tscircuit/probe-stage01/versions/v1/site/downloads/README.txt

Microscope probe lift — build123d prototype 03

End mount for a Ø44 mm microscope cylinder, with a nominal 44.4 mm split-clamp bore and a 100 mm working distance to the specimen. The carriage moves 40 mm straight vertically; the externally held probe remains 60° above the plate. A custom necked metal probe has a 1 mm stem in the central field and a 6 mm shank in the external collet. Confirm the actual objective envelope and optical field.

Drive: module 1, 20° pressure angle, 20-tooth pinion engaging 60 internal teeth in a 180° slot of a virtual 120-tooth ring. Ratio 6:1. Wheel OD 136 mm; crank radius 25 mm; connecting rod 110 mm; wheel sweep approximately 106.26° for the 40 mm stroke.

Probe reference: custom 104 mm metal probe. The first 4 mm is pointed; the 1 mm stem continues to 60 mm from the tip; a taper spans 60–70 mm; the 6 mm shank spans 70–104 mm. Collet mid-plane is 90 mm from the tip, at world X=45 mm. This is an illustrative probe geometry, not a supplied or load-rated probe. Confirm suitability for your experiment.

Hardware: four 625ZZ bearings (5 × 16 × 5 mm). M5 structural and pivot fasteners; four M3 motor mounting screws. Modeled M5 heads are low profile, 8.5 mm diameter × 3.5 mm high. Use smooth precision 5 mm running sections through bearing races, with M5 threads outside the races. Standard 6 mm shoulder bolts do not fit. Verify actual screw lengths, head envelopes, motor mounting and shaft dimensions.

Nominal allowances: microscope bore +0.4 mm diameter; bearing seats +0.1 mm diameter; probe bore +0.35 mm diameter; M5 clearance holes 5.3 mm; dovetail lateral clearance 0.3 mm. Calibrate for your material and process. Do not clamp rotating bearing races with the surrounding printed shoulder.

All 48 exported components are valid single solids and passed STEP roundtrip checks. No intersections at 41 checked poses; Ø44 projected optical field clear of printed parts. Every component pair was checked at each pose (1128 pairs per pose), with no excluded parts or regions. A conservative full-length Ø6 mm probe envelope was also checked against every other component, replacing the necked probe reference. This is a geometry and motion prototype; stiffness, strength, backlash, fit tolerances and manufacturing need physical validation. These sampled checks do not prove clearance at every intermediate position. Separate conservative bounds keep every printed part outside the Ø44 projected barrel corridor throughout the prescribed vertical stroke, with the bounds checked against a 24 mm corridor radius. The projected footprint is not a measured lens field of view. The checked minimum gap between a full-length Ø6 mm probe envelope and the front clamp is 1.885 mm.

Audit threshold: positive-volume intersections greater than 1e-5 mm³ are reported. Tangent contact is allowed, including the lowered probe tip on the specimen. The Ø44 projected column is an optical clearance assumption from the barrel end to the specimen, not a measured microscope field. The slender metal probe intentionally enters that field; printed parts do not.

STEP is available for all 48 displayed components and the complete assembly. Genuine Parasolid x_t export is unavailable because no licensed writer is installed. Import STEP into a CAD tool with a Parasolid exporter to produce x_t. The complete bundle includes build123d source, requirements, all component STEP files, seven printable-part STLs, assembly STEP/GLB, viewer geometry, dimensions, manifests, checksums and verification reports. CAD downloads share the lowered contact-pose assembly placement; arrange STL orientations in your slicer.

Regenerate: install requirements.txt, then run python slider_crank_v3.py --out ./regenerated. Default assembly pose is lowered specimen contact at a 100 mm working distance. --angle selects a crank angle in degrees within ±53.130102354°. --working-distance changes the specimen offset and requires a new clearance audit. Viewer tessellation uses phi=0; the viewer applies rigid part transforms for animation.
