tscircuit/probe-stage01/validation/v4/v4-optical-40mm.png

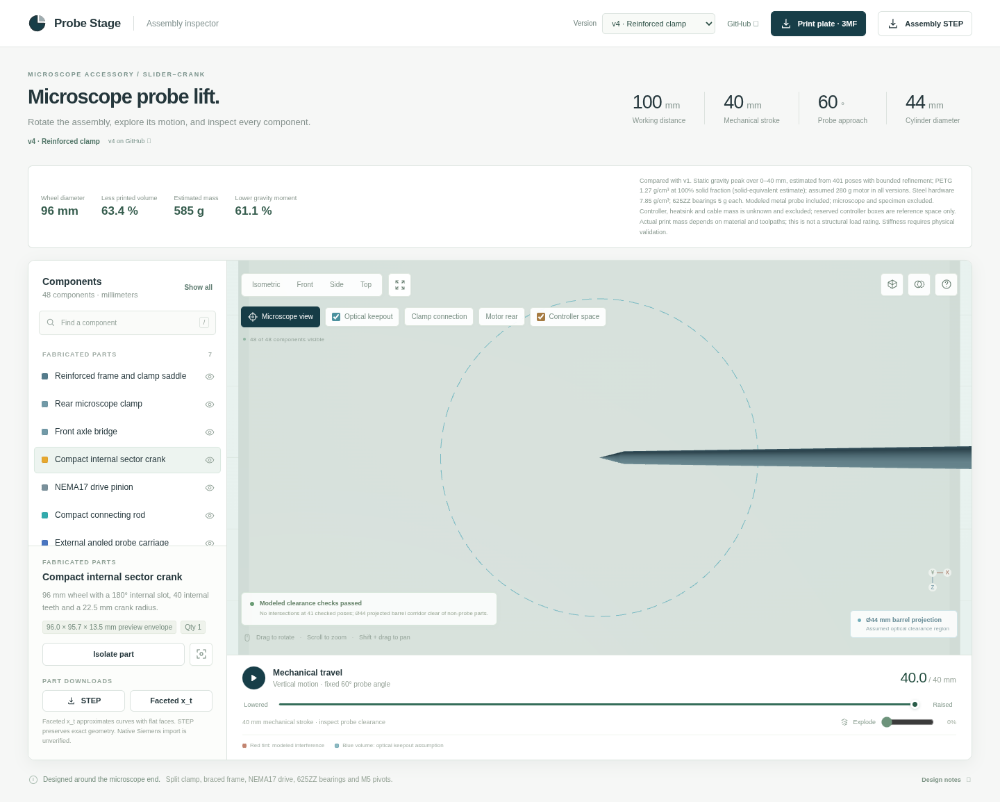
validation/v4/v4-optical-40mm.png
