tscircuit/probe-stage01/versions/v4/site/downloads/probe_stage_v4_assembly.step

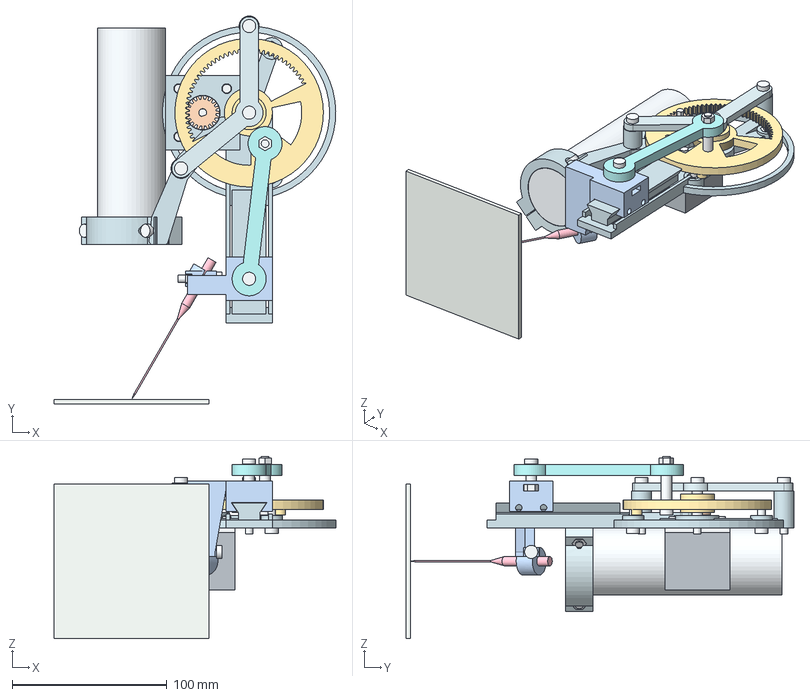
[picture p3: CAD file, 2026-10-10]
versions/v4/site/downloads/probe_stage_v4_assembly.step
182.0 x 250.8 x 117.7 mm
frame_front_clamp
rear_clamp
front_axle_bridge
sector_crank
motor_pinion
connecting_rod
probe_carriage
625ZZ_wheel_rear
625ZZ_wheel_front
625ZZ_crank
625ZZ_slider
wheel_inner_spacer
wheel_rear_spacer
wheel_front_spacer
crank_rear_spacer
crank_front_spacer
slider_rear_spacer
slider_front_spacer
M5_wheel_axle
M5_crank_bolt
M5_crank_nut
M5_slider_pivot_bolt
M5_slider_captive_nut
M5_axle_captive_nut
NEMA17_body
NEMA17_face
motor_shaft
M3_motor_-15.5_-15.5
M3_motor_-15.5_15.5
M3_motor_15.5_-15.5
M3_motor_15.5_15.5
M5_stop_-1
M5_stop_nut_-1
M5_stop_1
M5_stop_nut_1
M5_clamp_-28
M5_clamp_nut_-28
M5_clamp_28
M5_clamp_nut_28
M5_bridge_bolt_0
M5_bridge_nut_0
M5_bridge_bolt_1
M5_bridge_nut_1
M5_probe_clamp_bolt
M5_probe_clamp_nut
microscope_reference
probe_reference
specimen_plate_reference
