tscircuit/probe-stage01/print-plates/v4/probe-stage-v4-print-plate.3mf

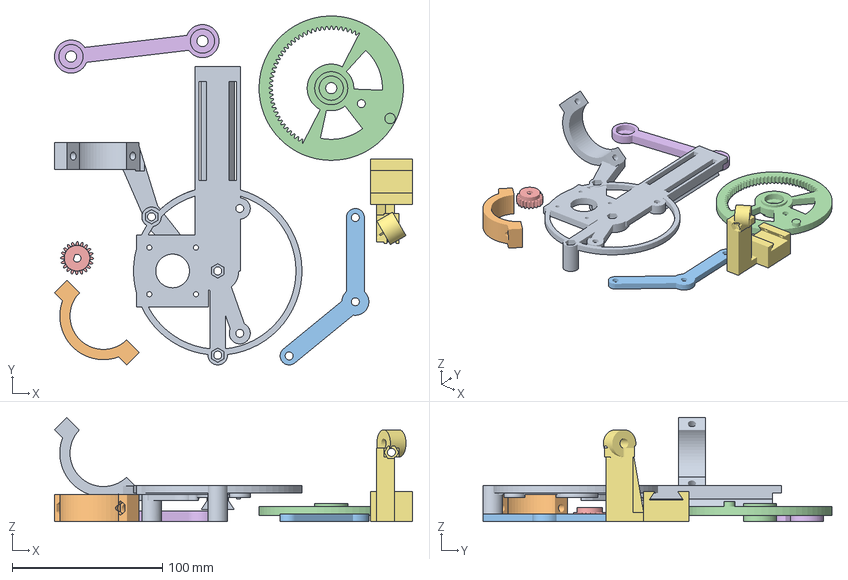
[picture p4: CAD file, 2026-10-10]
print-plates/v4/probe-stage-v4-print-plate.3mf
238.0 x 231.9 x 69.3 mm
frame_front_clamp
rear_clamp
front_axle_bridge
sector_crank
motor_pinion
connecting_rod
probe_carriage
