tscircuit/probe-stage01/versions/v4/site/downloads/parts/probe_reference.step

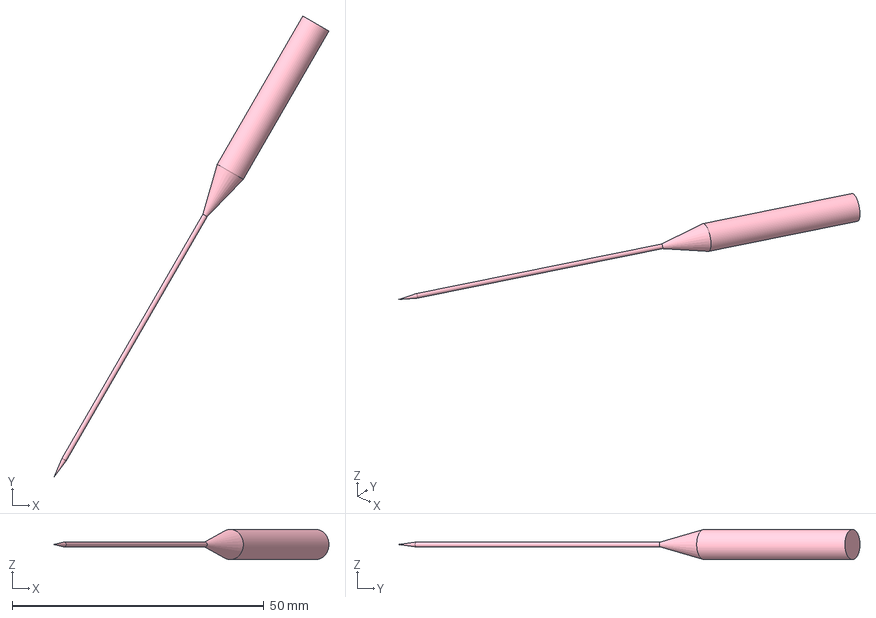
[picture p5: CAD file, 2026-10-10]
versions/v4/site/downloads/parts/probe_reference.step
54.6 x 91.6 x 6.00 mm
