tscircuit/probe-stage01/versions/v4/site/downloads/references/motor_controller_clearance_keepout.step

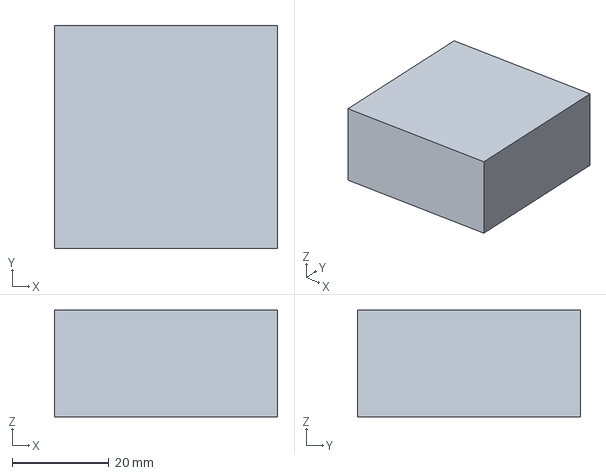
[picture p6: CAD file, 2026-10-10]
versions/v4/site/downloads/references/motor_controller_clearance_keepout.step
46.0 x 46.0 x 22.0 mm
