tscircuit/probe-stage01/versions/v4/site/downloads/parts/NEMA17_face.step

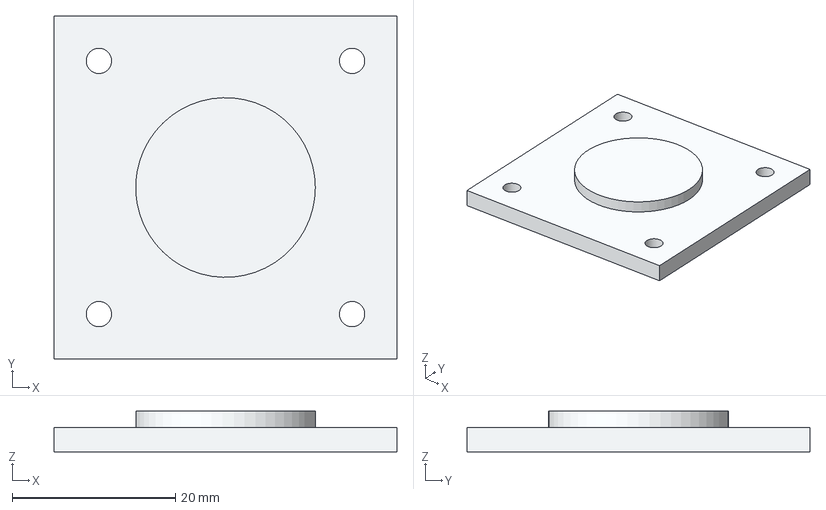
[picture p7: CAD file, 2026-10-10]
versions/v4/site/downloads/parts/NEMA17_face.step
42.0 x 42.0 x 5.00 mm
