tscircuit/probe-stage01/versions/v4/site/downloads/references/motor_controller_reserved_envelope.step

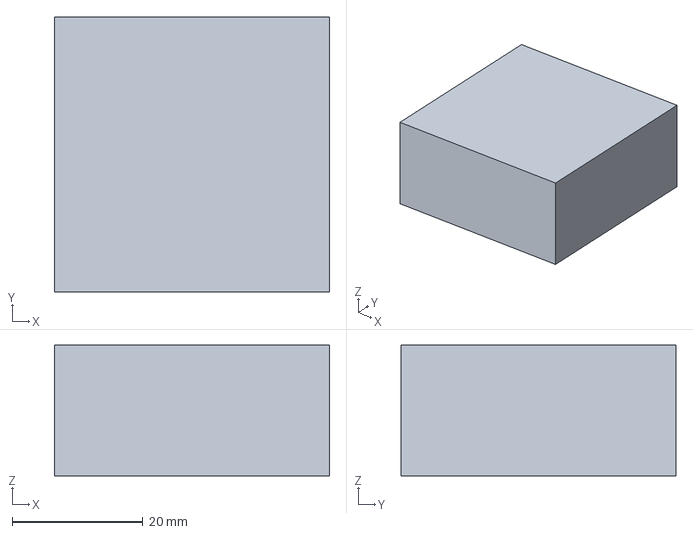
[picture p8: CAD file, 2026-10-10]
versions/v4/site/downloads/references/motor_controller_reserved_envelope.step
42.0 x 42.0 x 20.0 mm
