tscircuit/probe-stage01/versions/v4/site/downloads/parts/wheel_front_spacer.step

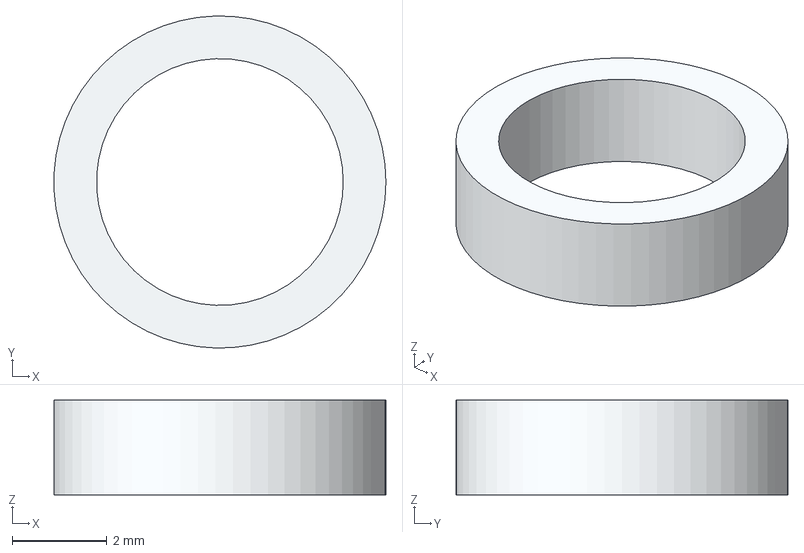
[picture p9: CAD file, 2026-10-10]
versions/v4/site/downloads/parts/wheel_front_spacer.step
7.00 x 7.00 x 2.00 mm
