tscircuit/probe-stage01/versions/v4/site/downloads/parts/slider_rear_spacer.step

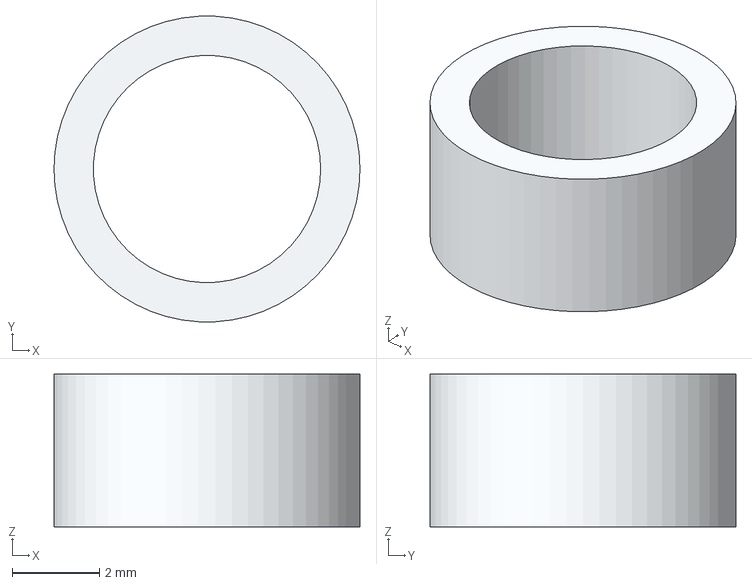
[picture p10: CAD file, 2026-10-10]
versions/v4/site/downloads/parts/slider_rear_spacer.step
7.00 x 6.99 x 3.50 mm
