tscircuit/probe-stage01/versions/v4/site/downloads/parts/microscope_reference.step

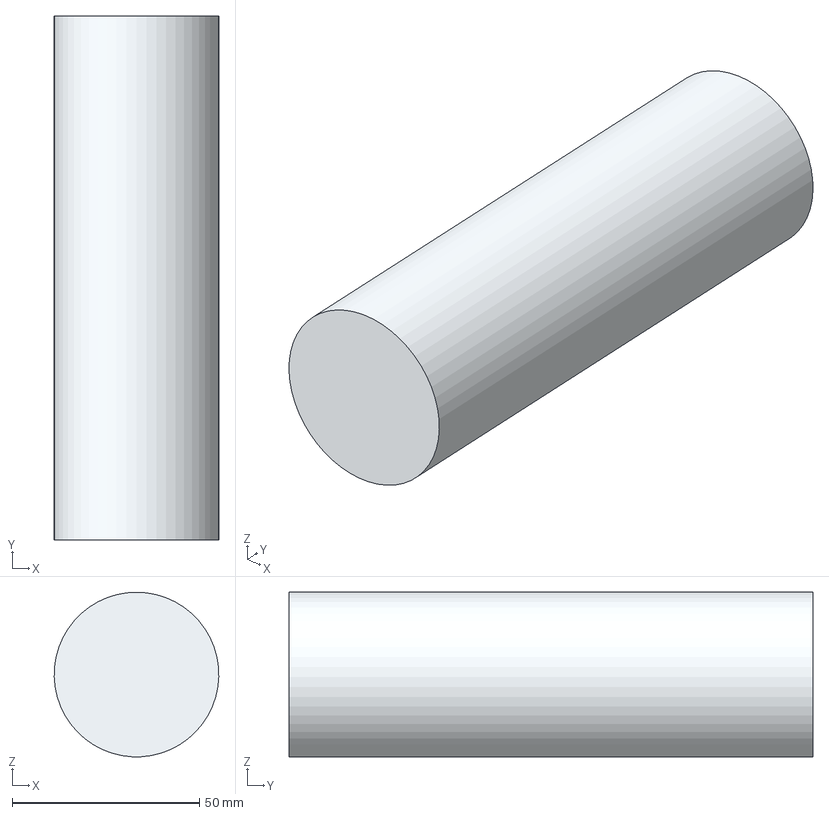
[picture p11: CAD file, 2026-10-10]
versions/v4/site/downloads/parts/microscope_reference.step
44.0 x 140.0 x 44.0 mm
