tscircuit/probe-stage01/versions/v4/site/downloads/parts/625ZZ_crank.step

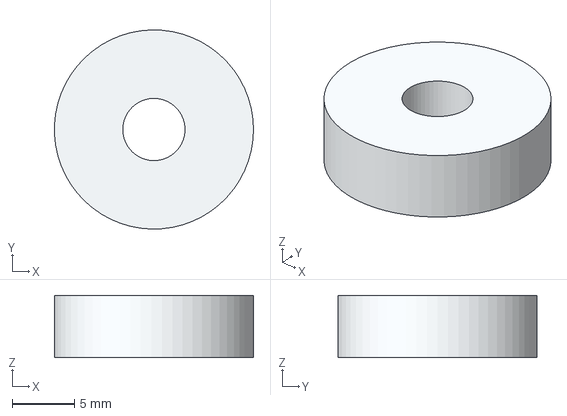
[picture p12: CAD file, 2026-10-10]
versions/v4/site/downloads/parts/625ZZ_crank.step
16.0 x 16.0 x 5.00 mm
