tscircuit/probe-stage01/versions/v4/site/downloads/parts/slider_front_spacer.step

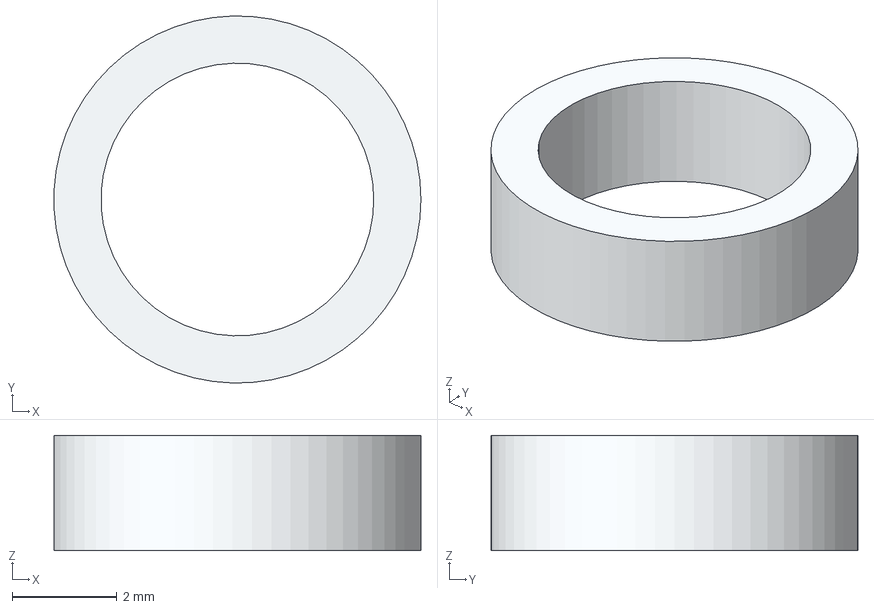
[picture p13: CAD file, 2026-10-10]
versions/v4/site/downloads/parts/slider_front_spacer.step
7.00 x 7.00 x 2.20 mm
