tscircuit/probe-stage01/versions/v4/site/downloads/parts/M5_wheel_axle.step

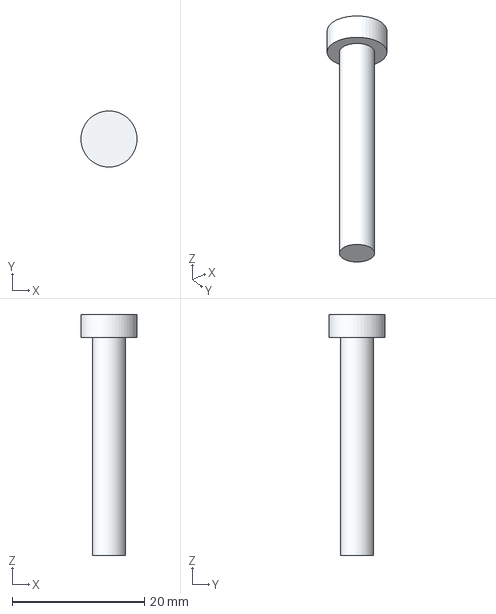
[picture p14: CAD file, 2026-10-10]
versions/v4/site/downloads/parts/M5_wheel_axle.step
8.49 x 8.50 x 36.5 mm
