tscircuit/probe-stage01/versions/v4/site/downloads/parts/sector_crank.step

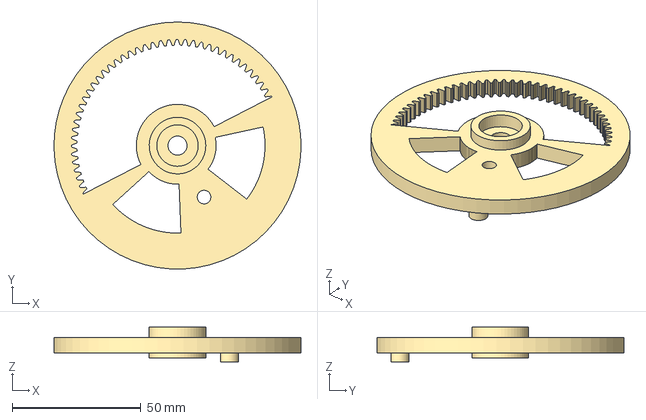
[picture p15: CAD file, 2026-10-10]
versions/v4/site/downloads/parts/sector_crank.step
96.0 x 95.9 x 13.5 mm
