tscircuit/probe-stage01/versions/v4/site/downloads/parts/M5_clamp_-28.step

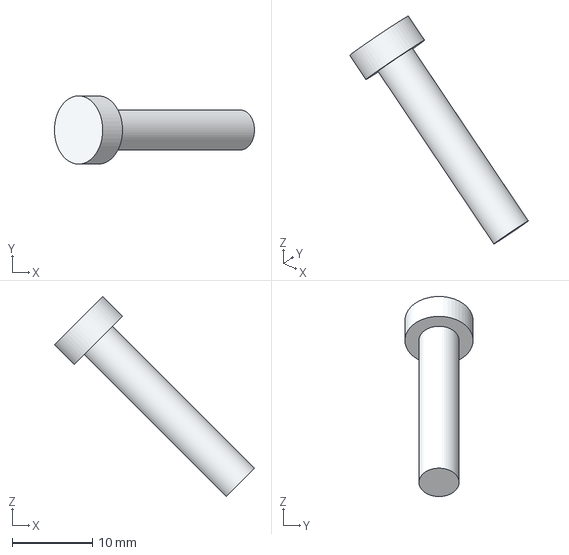
[picture p16: CAD file, 2026-10-10]
versions/v4/site/downloads/parts/M5_clamp_-28.step
24.9 x 8.50 x 24.9 mm
