tscircuit/probe-stage01/versions/v4/site/downloads/parts/M3_motor_-15.5_-15.5.step

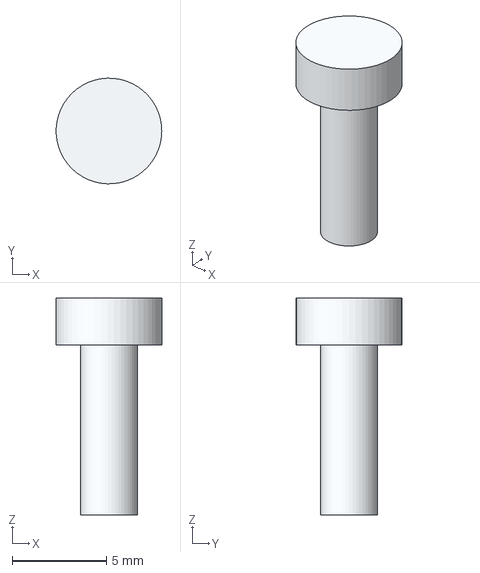
[picture p17: CAD file, 2026-10-10]
versions/v4/site/downloads/parts/M3_motor_-15.5_-15.5.step
5.59 x 5.60 x 11.5 mm
