tscircuit/probe-stage01/versions/v4/site/downloads/parts/connecting_rod.step

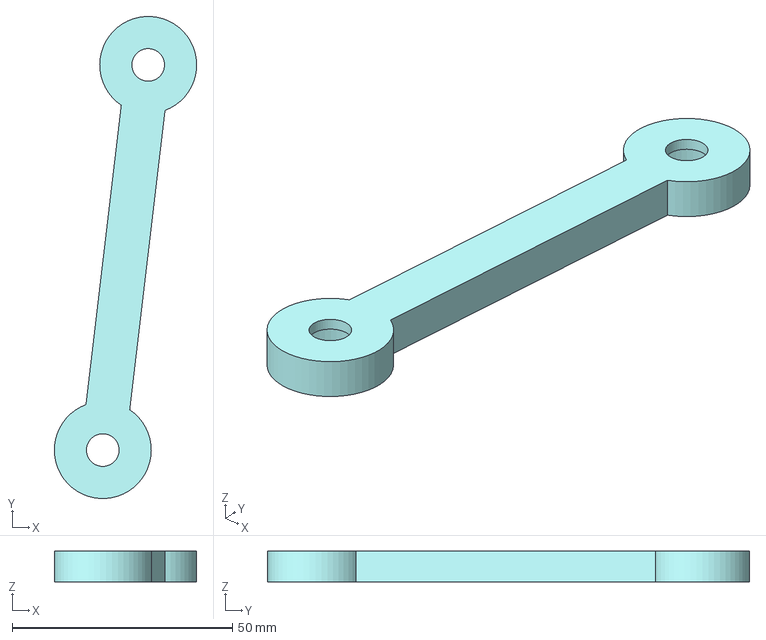
[picture p18: CAD file, 2026-10-10]
versions/v4/site/downloads/parts/connecting_rod.step
32.3 x 109.4 x 7.00 mm
