tscircuit/probe-stage01/versions/v4/site/downloads/parts/NEMA17_body.step

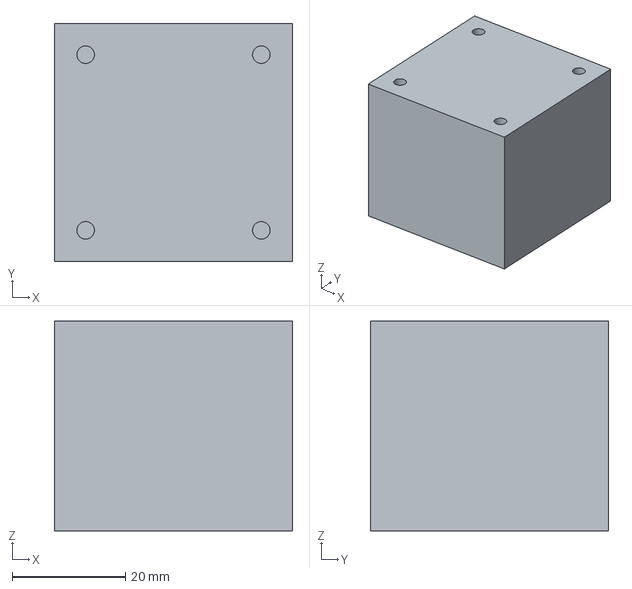
[picture p19: CAD file, 2026-10-10]
versions/v4/site/downloads/parts/NEMA17_body.step
42.0 x 42.0 x 37.0 mm
