tscircuit/probe-stage01/versions/v4/site/downloads/parts/motor_shaft.step

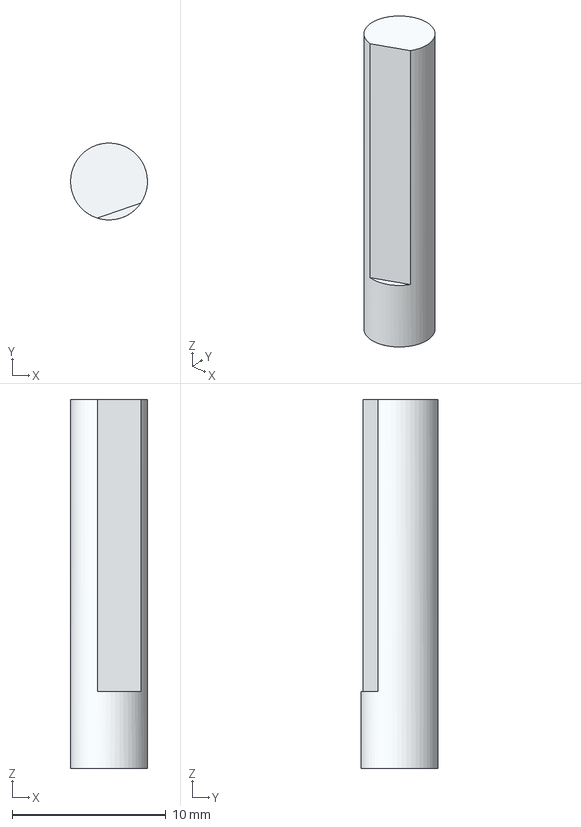
[picture p20: CAD file, 2026-10-10]
versions/v4/site/downloads/parts/motor_shaft.step
5.00 x 5.00 x 24.0 mm
