tscircuit/probe-stage01/versions/v4/site/downloads/parts/rear_clamp.step

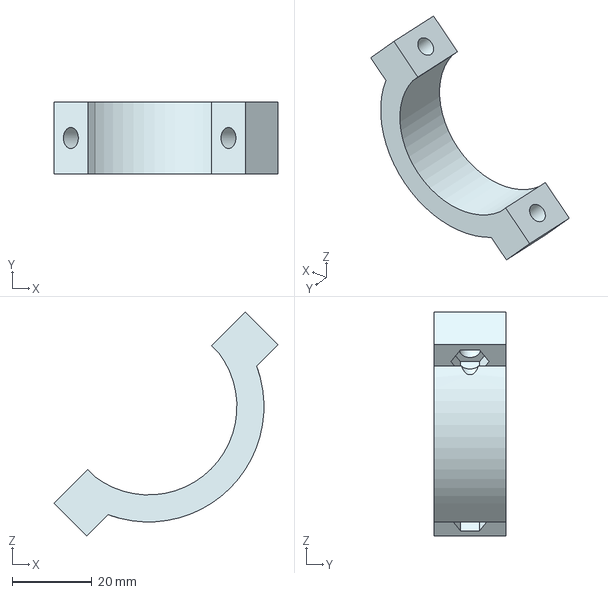
[picture p21: CAD file, 2026-10-10]
versions/v4/site/downloads/parts/rear_clamp.step
56.3 x 18.0 x 56.3 mm
