tscircuit/probe-stage01/versions/v4/site/downloads/parts/specimen_plate_reference.step

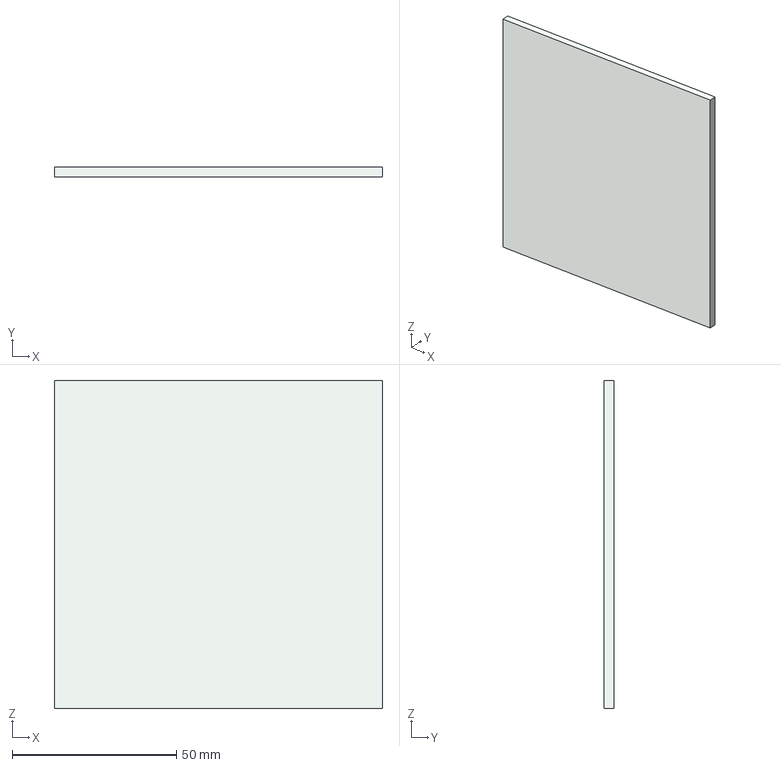
[picture p22: CAD file, 2026-10-10]
versions/v4/site/downloads/parts/specimen_plate_reference.step
100.0 x 3.00 x 100.0 mm
