tscircuit/probe-stage01/versions/v4/site/downloads/parts/probe_carriage.step

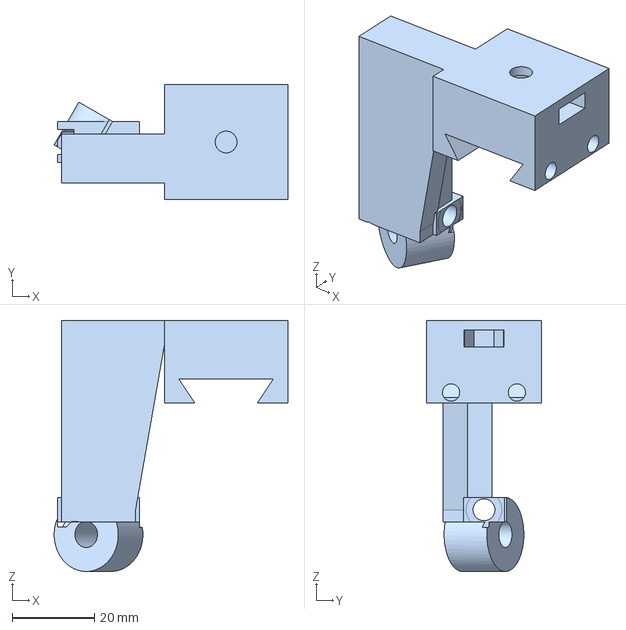
[picture p23: CAD file, 2026-10-10]
versions/v4/site/downloads/parts/probe_carriage.step
56.8 x 28.0 x 61.0 mm
