tscircuit/probe-stage01/versions/v4/site/downloads/parts/motor_pinion.step

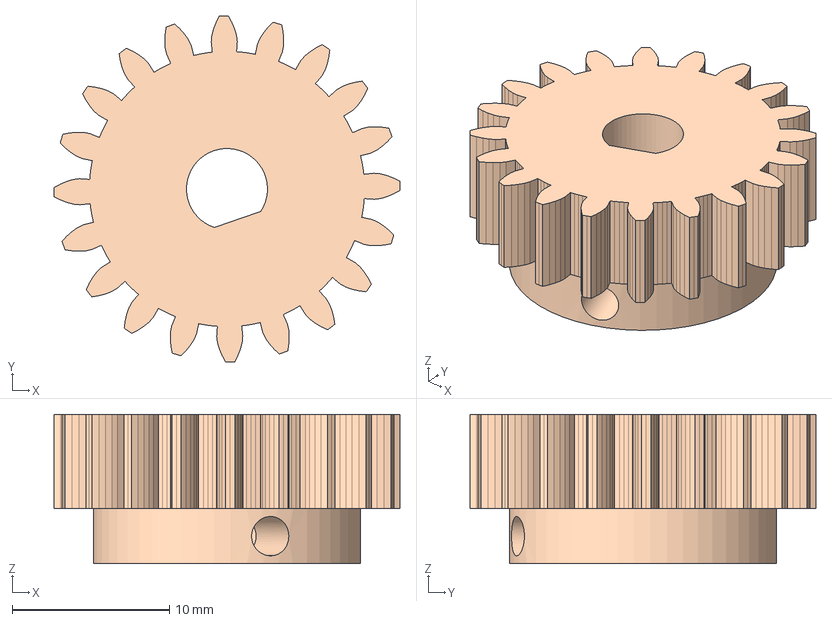
[picture p24: CAD file, 2026-10-10]
versions/v4/site/downloads/parts/motor_pinion.step
22.0 x 22.0 x 9.50 mm
