tscircuit/probe-stage01/versions/v4/site/downloads/parts/M5_stop_-1.step

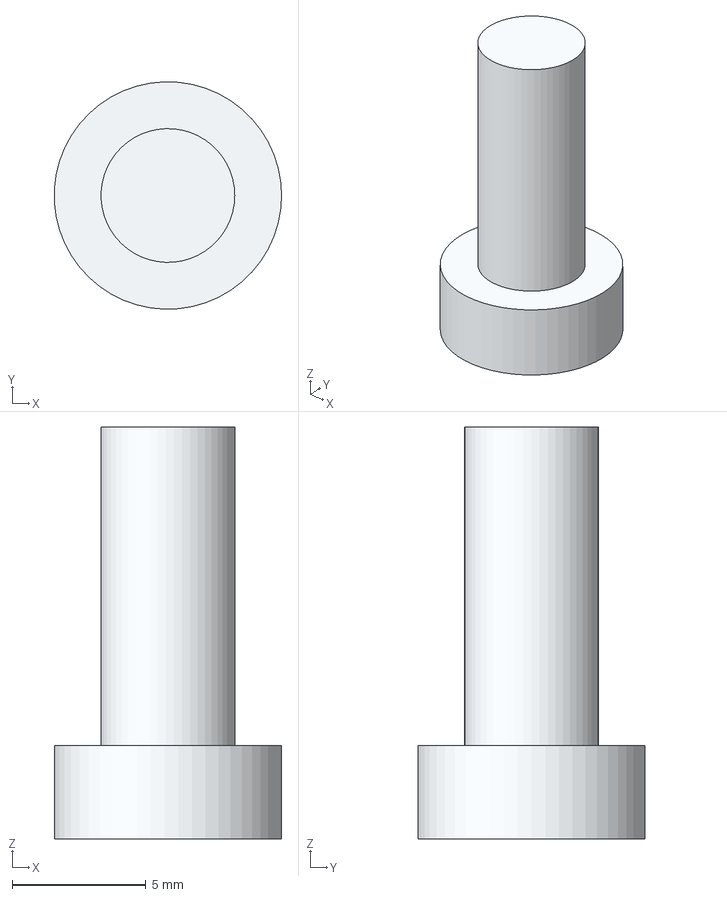
[picture p25: CAD file, 2026-10-10]
versions/v4/site/downloads/parts/M5_stop_-1.step
8.49 x 8.50 x 15.4 mm
