tscircuit/probe-stage01/versions/v4/site/downloads/parts/crank_rear_spacer.step

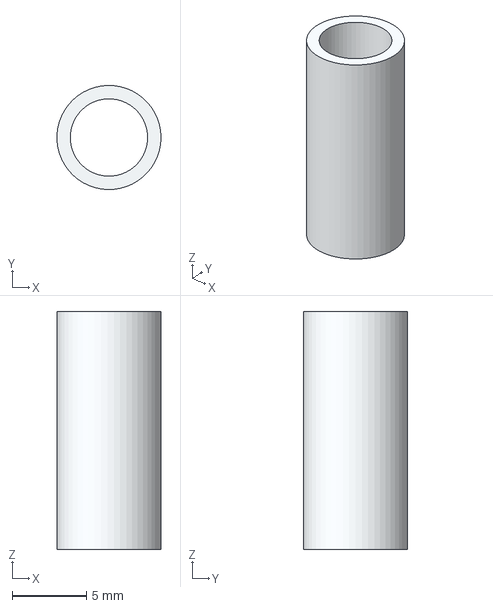
[picture p26: CAD file, 2026-10-10]
versions/v4/site/downloads/parts/crank_rear_spacer.step
6.99 x 7.00 x 16.0 mm
