tscircuit/probe-stage01/versions/v4/site/downloads/parts/frame_front_clamp.step

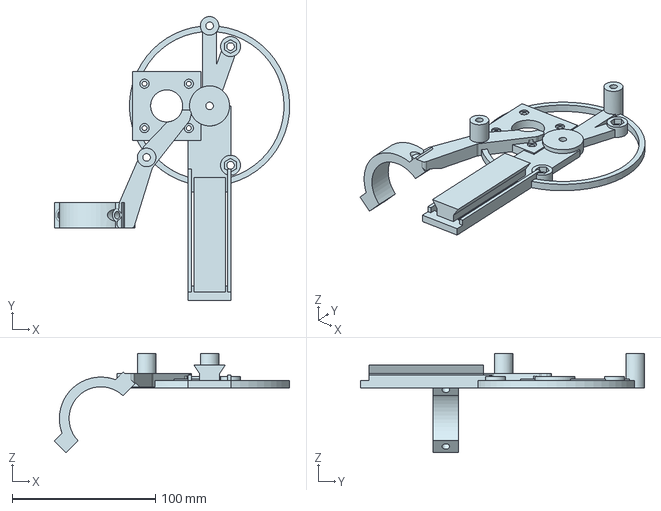
[picture p27: CAD file, 2026-10-10]
versions/v4/site/downloads/parts/frame_front_clamp.step
164.5 x 198.5 x 69.3 mm
