tscircuit/probe-stage01/versions/v4/site/downloads/parts/front_axle_bridge.step

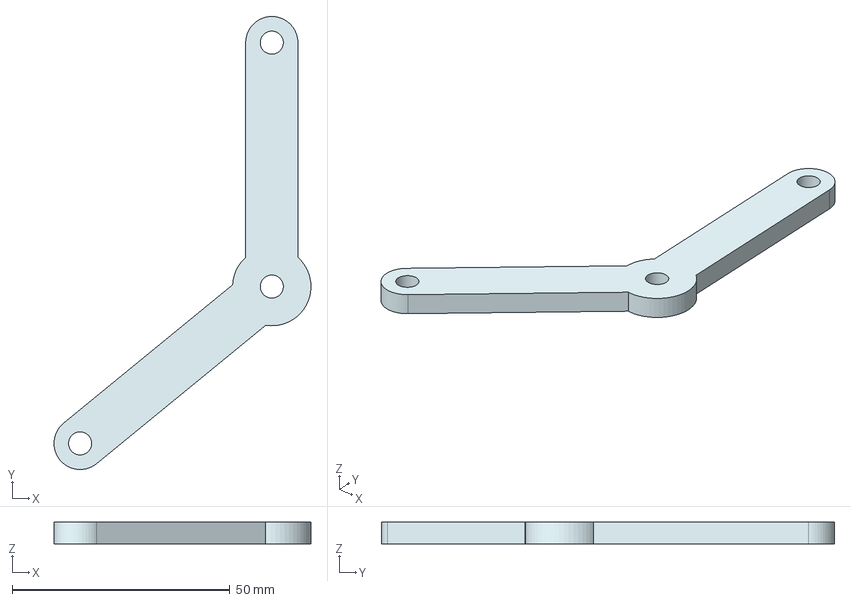
[picture p28: CAD file, 2026-10-10]
versions/v4/site/downloads/parts/front_axle_bridge.step
59.0 x 104.0 x 5.00 mm
