tscircuit/probe-stage01/(list of files, cad)

Other CAD files:
versions/v4/site/downloads/parts/wheel_rear_spacer.step
versions/v4/site/downloads/parts/625ZZ_wheel_front.step
versions/v4/site/downloads/parts/625ZZ_wheel_rear.step
versions/v4/site/downloads/parts/crank_front_spacer.step
versions/v4/site/downloads/parts/wheel_inner_spacer.step
versions/v4/site/downloads/parts/625ZZ_slider.step
faceted-parasolid/v1/parts/625ZZ_crank.faceted.x_t
faceted-parasolid/v1/parts/625ZZ_slider.faceted.x_t
faceted-parasolid/v1/parts/625ZZ_wheel_front.faceted.x_t
faceted-parasolid/v1/parts/625ZZ_wheel_rear.faceted.x_t
faceted-parasolid/v1/parts/M3_motor_-15.5_-15.5.faceted.x_t
faceted-parasolid/v1/parts/M3_motor_-15.5_15.5.faceted.x_t
faceted-parasolid/v1/parts/M3_motor_15.5_-15.5.faceted.x_t
faceted-parasolid/v1/parts/M3_motor_15.5_15.5.faceted.x_t
faceted-parasolid/v1/parts/M5_axle_captive_nut.faceted.x_t
faceted-parasolid/v1/parts/M5_bridge_bolt_0.faceted.x_t
faceted-parasolid/v1/parts/M5_bridge_bolt_1.faceted.x_t
faceted-parasolid/v1/parts/M5_bridge_nut_0.faceted.x_t
faceted-parasolid/v1/parts/M5_bridge_nut_1.faceted.x_t
faceted-parasolid/v1/parts/M5_clamp_-28.faceted.x_t
faceted-parasolid/v1/parts/M5_clamp_28.faceted.x_t
faceted-parasolid/v1/parts/M5_clamp_nut_-28.faceted.x_t
faceted-parasolid/v1/parts/M5_clamp_nut_28.faceted.x_t
faceted-parasolid/v1/parts/M5_crank_bolt.faceted.x_t
faceted-parasolid/v1/parts/M5_crank_nut.faceted.x_t
faceted-parasolid/v1/parts/M5_probe_clamp_bolt.faceted.x_t
faceted-parasolid/v1/parts/M5_slider_captive_nut.faceted.x_t
faceted-parasolid/v1/parts/M5_slider_pivot_bolt.faceted.x_t
faceted-parasolid/v1/parts/M5_stop_-1.faceted.x_t
faceted-parasolid/v1/parts/M5_stop_1.faceted.x_t
faceted-parasolid/v1/parts/M5_stop_nut_-1.faceted.x_t
faceted-parasolid/v1/parts/M5_stop_nut_1.faceted.x_t
faceted-parasolid/v1/parts/M5_wheel_axle.faceted.x_t
faceted-parasolid/v1/parts/NEMA17_body.faceted.x_t
faceted-parasolid/v1/parts/NEMA17_face.faceted.x_t
faceted-parasolid/v1/parts/connecting_rod.faceted.x_t
faceted-parasolid/v1/parts/crank_front_spacer.faceted.x_t
faceted-parasolid/v1/parts/crank_rear_spacer.faceted.x_t
faceted-parasolid/v1/parts/front_axle_bridge.faceted.x_t
faceted-parasolid/v1/parts/motor_pinion.faceted.x_t
faceted-parasolid/v1/parts/motor_shaft.faceted.x_t
faceted-parasolid/v1/parts/probe_carriage.faceted.x_t
faceted-parasolid/v1/parts/probe_reference.faceted.x_t
faceted-parasolid/v1/parts/sector_crank.faceted.x_t
faceted-parasolid/v1/parts/slider_front_spacer.faceted.x_t
faceted-parasolid/v1/parts/slider_rear_spacer.faceted.x_t
faceted-parasolid/v1/parts/wheel_front_spacer.faceted.x_t
faceted-parasolid/v1/parts/wheel_inner_spacer.faceted.x_t
faceted-parasolid/v1/parts/wheel_rear_spacer.faceted.x_t
faceted-parasolid/v2/parts/625ZZ_crank.faceted.x_t
faceted-parasolid/v2/parts/625ZZ_slider.faceted.x_t
faceted-parasolid/v2/parts/625ZZ_wheel_front.faceted.x_t
faceted-parasolid/v2/parts/625ZZ_wheel_rear.faceted.x_t
faceted-parasolid/v2/parts/M3_motor_-15.5_-15.5.faceted.x_t
faceted-parasolid/v2/parts/M3_motor_-15.5_15.5.faceted.x_t
faceted-parasolid/v2/parts/M3_motor_15.5_-15.5.faceted.x_t
faceted-parasolid/v2/parts/M3_motor_15.5_15.5.faceted.x_t
faceted-parasolid/v2/parts/M5_axle_captive_nut.faceted.x_t
faceted-parasolid/v2/parts/M5_bridge_bolt_0.faceted.x_t
faceted-parasolid/v2/parts/M5_bridge_bolt_1.faceted.x_t
faceted-parasolid/v2/parts/M5_bridge_nut_0.faceted.x_t
faceted-parasolid/v2/parts/M5_bridge_nut_1.faceted.x_t
faceted-parasolid/v2/parts/M5_crank_bolt.faceted.x_t
faceted-parasolid/v2/parts/M5_crank_nut.faceted.x_t
faceted-parasolid/v2/parts/M5_probe_clamp_bolt.faceted.x_t
faceted-parasolid/v2/parts/M5_probe_clamp_nut.faceted.x_t
faceted-parasolid/v2/parts/M5_slider_captive_nut.faceted.x_t
faceted-parasolid/v2/parts/M5_slider_pivot_bolt.faceted.x_t
faceted-parasolid/v2/parts/M5_stop_-1.faceted.x_t
faceted-parasolid/v2/parts/M5_stop_1.faceted.x_t
faceted-parasolid/v2/parts/M5_stop_nut_-1.faceted.x_t
faceted-parasolid/v2/parts/M5_stop_nut_1.faceted.x_t
faceted-parasolid/v2/parts/M5_wheel_axle.faceted.x_t
faceted-parasolid/v2/parts/NEMA17_body.faceted.x_t
faceted-parasolid/v2/parts/NEMA17_face.faceted.x_t
faceted-parasolid/v2/parts/connecting_rod.faceted.x_t
faceted-parasolid/v2/parts/crank_front_spacer.faceted.x_t
faceted-parasolid/v2/parts/crank_rear_spacer.faceted.x_t
faceted-parasolid/v2/parts/frame_front_clamp.faceted.x_t
faceted-parasolid/v2/parts/front_axle_bridge.faceted.x_t
faceted-parasolid/v2/parts/motor_pinion.faceted.x_t
faceted-parasolid/v2/parts/motor_shaft.faceted.x_t
faceted-parasolid/v2/parts/probe_carriage.faceted.x_t
faceted-parasolid/v2/parts/probe_reference.faceted.x_t
faceted-parasolid/v2/parts/rear_clamp.faceted.x_t
faceted-parasolid/v2/parts/sector_crank.faceted.x_t
faceted-parasolid/v2/parts/slider_front_spacer.faceted.x_t
faceted-parasolid/v2/parts/slider_rear_spacer.faceted.x_t
faceted-parasolid/v2/parts/wheel_front_spacer.faceted.x_t
faceted-parasolid/v2/parts/wheel_inner_spacer.faceted.x_t
faceted-parasolid/v2/parts/wheel_rear_spacer.faceted.x_t
faceted-parasolid/v3/parts/625ZZ_wheel_rear.faceted.x_t
faceted-parasolid/v3/parts/M3_motor_-15.5_-15.5.faceted.x_t
faceted-parasolid/v3/parts/M3_motor_-15.5_15.5.faceted.x_t
faceted-parasolid/v3/parts/M3_motor_15.5_-15.5.faceted.x_t
faceted-parasolid/v3/parts/M3_motor_15.5_15.5.faceted.x_t
faceted-parasolid/v3/parts/M5_bridge_bolt_1.faceted.x_t
faceted-parasolid/v3/parts/M5_bridge_nut_0.faceted.x_t
faceted-parasolid/v3/parts/M5_bridge_nut_1.faceted.x_t
faceted-parasolid/v3/parts/M5_clamp_-28.faceted.x_t
faceted-parasolid/v3/parts/M5_crank_nut.faceted.x_t
faceted-parasolid/v3/parts/M5_probe_clamp_bolt.faceted.x_t
faceted-parasolid/v3/parts/M5_stop_1.faceted.x_t
faceted-parasolid/v3/parts/M5_wheel_axle.faceted.x_t
faceted-parasolid/v3/parts/NEMA17_body.faceted.x_t
faceted-parasolid/v3/parts/crank_front_spacer.faceted.x_t
faceted-parasolid/v3/parts/frame_front_clamp.faceted.x_t
faceted-parasolid/v3/parts/microscope_reference.faceted.x_t
faceted-parasolid/v3/parts/motor_pinion.faceted.x_t
faceted-parasolid/v3/parts/motor_shaft.faceted.x_t
faceted-parasolid/v3/parts/probe_carriage.faceted.x_t
faceted-parasolid/v3/parts/rear_clamp.faceted.x_t
faceted-parasolid/v3/parts/sector_crank.faceted.x_t
faceted-parasolid/v3/parts/slider_front_spacer.faceted.x_t
faceted-parasolid/v3/parts/slider_rear_spacer.faceted.x_t
faceted-parasolid/v3/parts/specimen_plate_reference.faceted.x_t
faceted-parasolid/v3/parts/wheel_front_spacer.faceted.x_t
faceted-parasolid/v3/parts/wheel_inner_spacer.faceted.x_t
faceted-parasolid/v3/parts/wheel_rear_spacer.faceted.x_t
faceted-parasolid/v4/parts/625ZZ_crank.faceted.x_t
faceted-parasolid/v4/parts/625ZZ_slider.faceted.x_t
faceted-parasolid/v4/parts/625ZZ_wheel_front.faceted.x_t
faceted-parasolid/v4/parts/M5_axle_captive_nut.faceted.x_t
faceted-parasolid/v4/parts/M5_bridge_bolt_0.faceted.x_t
faceted-parasolid/v4/parts/M5_clamp_28.faceted.x_t
faceted-parasolid/v4/parts/M5_clamp_nut_-28.faceted.x_t
faceted-parasolid/v4/parts/M5_clamp_nut_28.faceted.x_t
faceted-parasolid/v4/parts/M5_crank_bolt.faceted.x_t
faceted-parasolid/v4/parts/M5_probe_clamp_nut.faceted.x_t
faceted-parasolid/v4/parts/M5_slider_captive_nut.faceted.x_t
faceted-parasolid/v4/parts/M5_slider_pivot_bolt.faceted.x_t
faceted-parasolid/v4/parts/M5_stop_-1.faceted.x_t
faceted-parasolid/v4/parts/M5_stop_nut_-1.faceted.x_t
faceted-parasolid/v4/parts/M5_stop_nut_1.faceted.x_t
faceted-parasolid/v4/parts/NEMA17_face.faceted.x_t
faceted-parasolid/v4/parts/connecting_rod.faceted.x_t
faceted-parasolid/v4/parts/crank_rear_spacer.faceted.x_t
faceted-parasolid/v4/parts/frame_front_clamp.faceted.x_t
faceted-parasolid/v4/parts/front_axle_bridge.faceted.x_t
faceted-parasolid/v4/parts/probe_reference.faceted.x_t
print-plates/v2/probe-stage-v2-print-plate.3mf
print-plates/v3/probe-stage-v3-print-plate.3mf
versions/v1/site/downloads/parts/625ZZ_crank.step
versions/v1/site/downloads/parts/625ZZ_slider.step
versions/v1/site/downloads/parts/625ZZ_wheel_front.step
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
