tscircuit/probe-stage01/validation/v4/v3-clamp-desktop.png

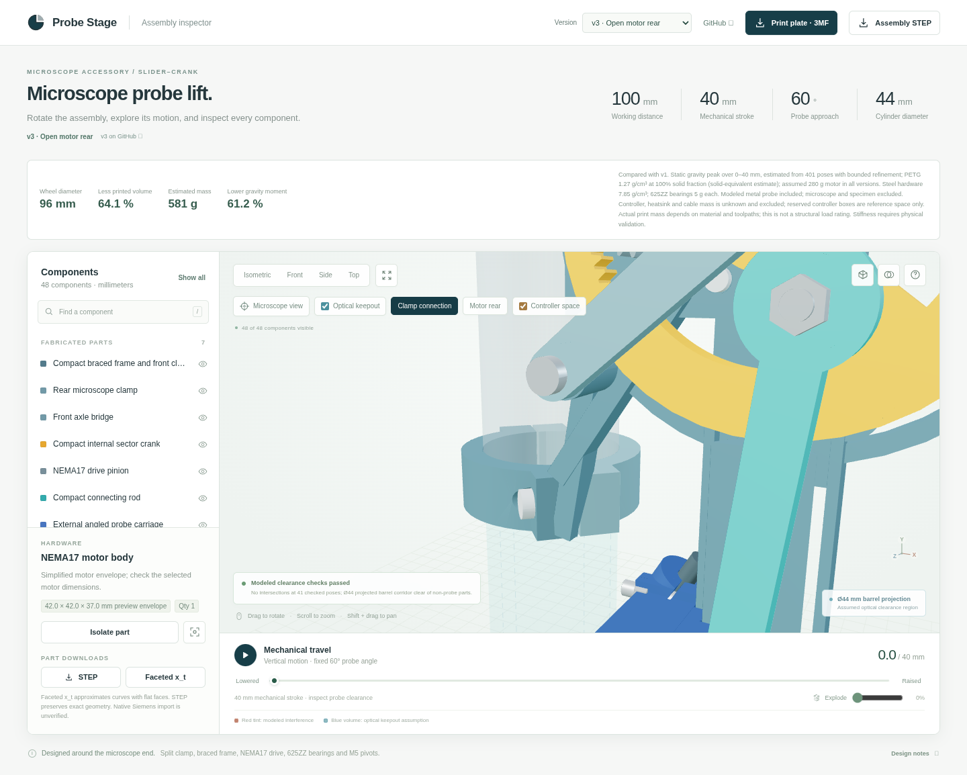
validation/v4/v3-clamp-desktop.png
