tscircuit/probe-stage01/validation/v4/v4-clamp-mobile.png

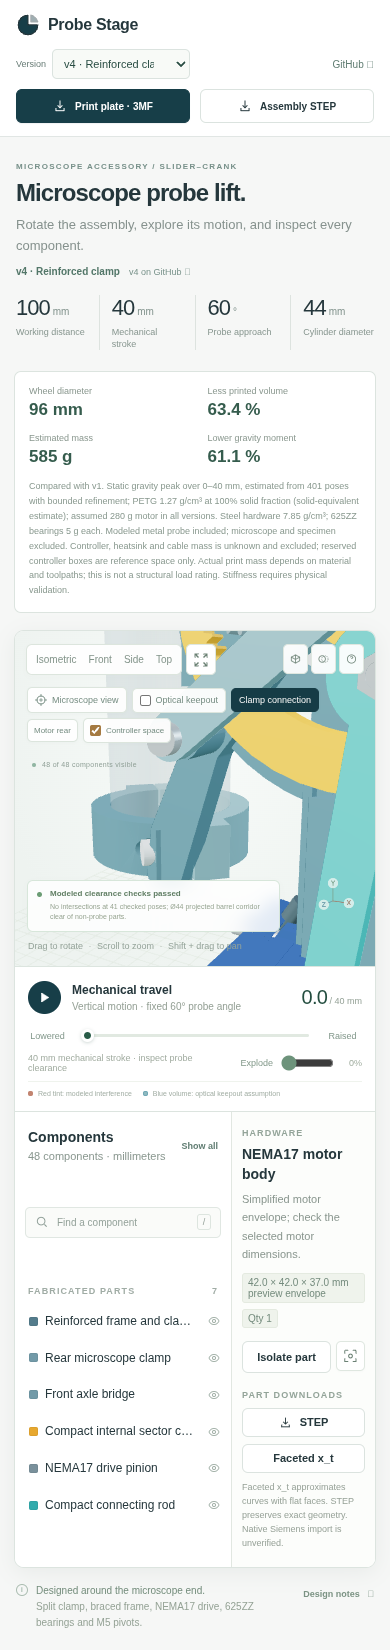
validation/v4/v4-clamp-mobile.png
