tscircuit/probe-stage01/validation/v4/v4-isometric-desktop.png

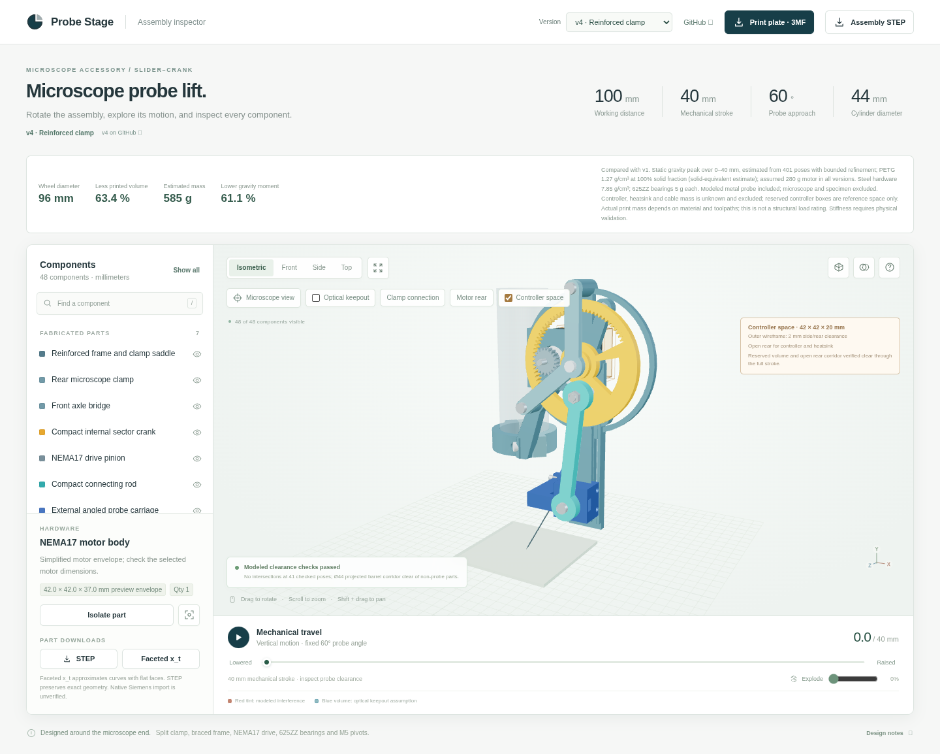
validation/v4/v4-isometric-desktop.png
