tscircuit/probe-stage01/(commit log)

2026-10-10 Preserve validated microscope probe stage as release v1
2026-10-10 Release compact v2 with versioned inspector and CAD exports
2026-10-10 Add v3 probe stage with open motor rear and controller clearance
2026-10-10 Add printable-only 3MF plate downloads for v2 and v3
2026-10-10 Reinforce microscope clamp connection in v4
